sahanrashmikaslk/BJT_Amplifier-Using_Proteus/BJT_Amplifier-Report.pdf

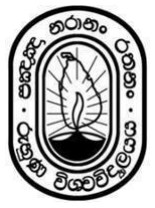
[picture p7: figure]

# BJT AMPLIFIER DESIGN

### A report submitted to the

### Department of Electrical and Information Engineering

### Faculty of Engineering

### University of Ruhuna Sri Lanka

### On 20th SEP 2023

### In completing an assignment for the module

### EE 4105 – Electronics Project

By

### Group 17

EG/2020/4036 | KUMARI H.M.M.S
EG/2020/4038 | KURUWITAARACHCHI K.A.D.T.T
EG/2020/4040 | LAKPAHANA A.G.S
EG/2020/4044 | LAKSHANI P.N.K
EG/2020/4047 | LELWALA L.G.S.R

ABSTRACT

This project report primarily revolves around the construction of a common emitter BJT amplifier that meets specific criteria for gain and bandwidth. It encompasses the entire journey of creating this amplifier, starting from the initial idea to the final product. This comprehensive process includes defining design specifications, performing critical calculations, simulating the circuit, designing the PCB layout, physically building the amplifier, analyzing the results, and drawing meaningful conclusions.

PERFACE

In the scope of our EE4105 - Electronic Project module, our team effectively tackled the challenge

of crafting a customized BJT amplifier with precise gain and bandwidth specifications. This

project provided us with invaluable insights into the intricacies of BJT amplifier design. The

following report serves as a detailed record of our discoveries and accomplishments throughout

this journey. We would like to express our sincere gratitude to Mr. Saman De Silva, our instructor

for the EE4105 module in the Department of Electrical and Electronic Engineering, for granting us

the opportunity to compile this report and for his continuous guidance and motivation.

Group 17:

EG/2020/4036 | KUMARI H.M.M.S
EG/2020/4038 | KURUWITAARACHCHI K.A.D.T.T
EG/2020/4040 | LAKPAHANA A.G.S
EG/2020/4044 | LAKSHANI P.N.K
EG/2020/4047 | LELWALA L.G.S.R

Department of Electrical and Information Engineering,

University of Ruhuna.

TABLE OF CONTENT

LIST OF FIGURES

### 1. Introduction

The common emitter amplifier, which is a voltage amplification circuit, consists of a three-terminal

bipolar junction transistor in a single-stage configuration. In this setup, it acquires its input signal

via the base terminal, collects the amplified output from the collector terminal, and links the emitter

terminal to both the input and output sides.

This single-stage common emitter amplifier circuit relies on Voltage Divider Biasing, a specific

biasing technique. Within this method, two resistors form a voltage division network across the

power supply, and the midpoint of this network generates the necessary base bias voltage for the

transistor. Voltage divider biasing is a widely adopted strategy when designing amplifier circuits

based on bipolar transistors.

### 1.1. Problem Statement

The project task was to implement a Common Emitter BJT amplifier with the following

Specifications.

- Voltage gain | = 400
- Bandwidth of Low Pass Filter | = 1.5kHz

This amplifier is designed to amplify weak audio signals, eliminate unwanted high-frequency noise, and invert the signal's phase as needed in audio applications.

### 1.2. Objectives

- By having a knowledge about how BJT is amplify by controlling the current flow we have to understand the construction and working principle of BJT amplifiers
- Component values like resistors and capacitors are calculated based on given

specifications to ensure the circuit's intended performance

- Sketch and simulate the designed common emitter amplifier circuit by proteus for insights into its behavior.
- Implementation on a PCB layout requires precision in component placement and routing,

often visualized in 3D.

- Comparing the theoretical and experimental results checks the design and helps make it

better, showing how electronics engineering often involves trying, testing, and improving

### 1.3. Methodology

- Gather information like how much it should amplify the signal, what frequencies it should work with on the BJT common emitter amplifier to compute component values.
- Select an appropriate transistors based on the calculated voltage and current values.
- Develop a block diagram that illustrates the amplifier and filter stages.
- Perform the necessary calculations to determine component values according to specified characteristics.
- Utilize Proteus software to simulate the designed circuit. This helps you to see the design works on the computer properly and if there are any issues, fix them through troubleshooting.
- Implement the circuit design on a printed circuit board
- Concluding the theoretical and practical performances of the design by mentioning the

conclusions of this report.

- Preparing and presenting the final design and the report.

### 2. Design of the Amplifier

### 2.1. Top Level Construction of the Design

In the amplifier design, it is expected the amplifier gain should be 400 and the bandwidth

should be 1.5kHz.

The 400 gain is somewhat higher gain than the normal cases. So we cannot achieve this through

only one amplifier. So here two amplifiers are used cascading. Then for the achieve bandwidth

requirement, filter is used and the buffer circuits ensure the input/output impedance matching at

various stages as the beginning, middle of two amplifiers and the end of the amplifier in the

amplifier circuit.

The block diagram of the amplifier circuit as follows.

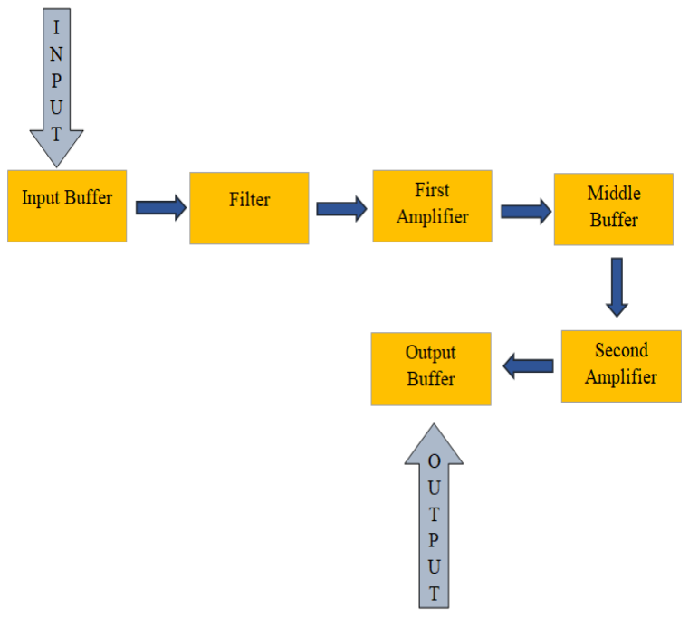
[picture p8: figure]

Figure 1 : Block Diagram of the Amplifier Circuit

### 2.1.1. Input Buffer

The BJT Common collector amplifier is used as input buffer to match the impedance of input

signal source with the amplifier. The gain is nearly about 1 and the bandwidth is much higher

than 1.5kHz.

### 2.1.2. Filter

Second order low pass Butterworth filter is used for achieve the bandwidth of 1.5kHz. The filter

gain is about 1. Then bandwidth is 1.5kHz.

### 2.1.3. First Amplifier

The BJT Common-emitter amplifier is used as first amplifier for the circuit. The gain of the first

amplifier is 20. Bandwidth is much more than 1.5kHz.

### 2.1.4. Middle Buffer

The BJT Common collector amplifier is use as middle buffer to match the output impedance of

the first filter and the input of the second filter. The gain is about 1 and bandwidth is much more

than 1.5kHz.

### 2.1.5. Second Amplifier

The BJT Common-emitter amplifier is used as second amplifier for the circuit. The gain of the

second amplifier is 20. Bandwidth is much more than 1.5kHz.

### 2.1.6. Output Buffer

The BJT Common collector amplifier is use as output buffer to match the output impedance of

the second filter and the output source. The gain is about 1 and bandwidth is much more than

1.5kHz.

### 2.2. Transistor Selection

The 2N3904 NPN transistor is used for all the stages as transistor for this amplifier circuit. This

2N3904 transistor is used for input buffer, filter, first amplifier, middle buffer, second amplifier

and output amplifier in the circuit.

Common properties for this transistor is as follow.

- Continuous Collector Current | - 200mA
- DC Current Gain(Minimum) | - 100
- Input Capacitive | - 8pF

### 2.3. Calculations

Calculations for the all the buffers, filter and the amplifiers are able to done isolating each

section form others because the effect of one section is not depend on other stages.

It is chose 12V as power supply for the amplifier circuit. All the parts in the amplifier is

powered by 12V DC power supply.

### 2.3.1. Input Buffer

As above mentioned Common Collector amplifier is used as input buffer for the circuit. The

construction of the common collector amplifier as shown in the below.

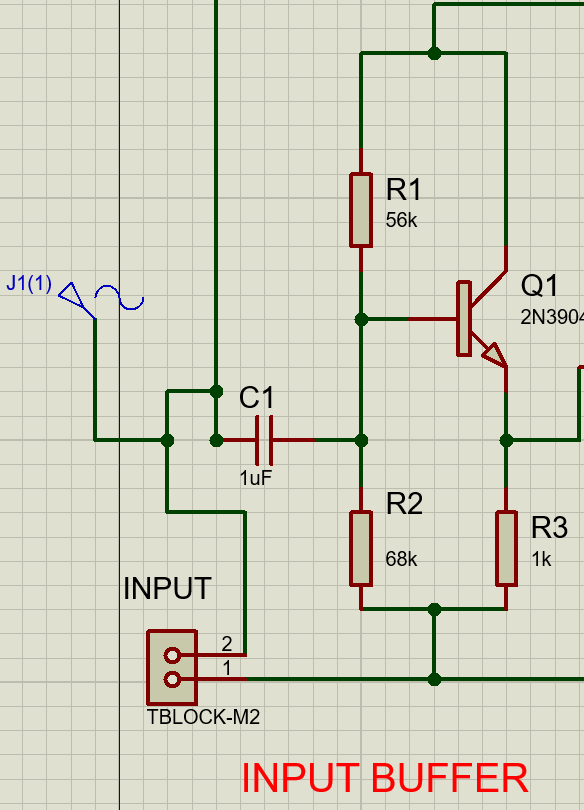
[picture p9: figure]

Figure 2 : Input Buffer Circuit

Calculations:

For a largest possible symmetric output voltage swing,

VE =

1
2

VCC

VE =

1
2

× 12V

VE = 6V

Then the Q point used for the calculations,

VCE = 6V

IC = 6mA

Normally IC ≈ IE,

Then Emitter resistor value,

RE =

VE
IE

R3 =

6V
6mA

R3 = 1kΩ

Base voltage of Q1 transistor,

VB = VE + 0.7V

VB = 6V + 0.7V

VB = 6.7V

Then R1 and R2 values are,

VB =

R2 × VCC
R1 + R2

VB = 6.7V

6.7V =

R2 × 12V
R1 + R2

R1
R2

=

5.3
6.7

R1 = 56kΩ

R2 = 68kΩ

Input impedance of the buffer

Zin = R1 ∥ R2 ∥ [βrE + (1 + β) ]RE

Hence rE ≪ RE

Zin = R1 ∥ R2 ∥ βRE

Zin = 56kΩ ∥ 68kΩ ∥ 100 × 1kΩ

Zin = 23.5kΩ

To get lower cutoff frequency around 10Hz,

C1 =

1
2π × f × Zin

C1 ≈ 1μF

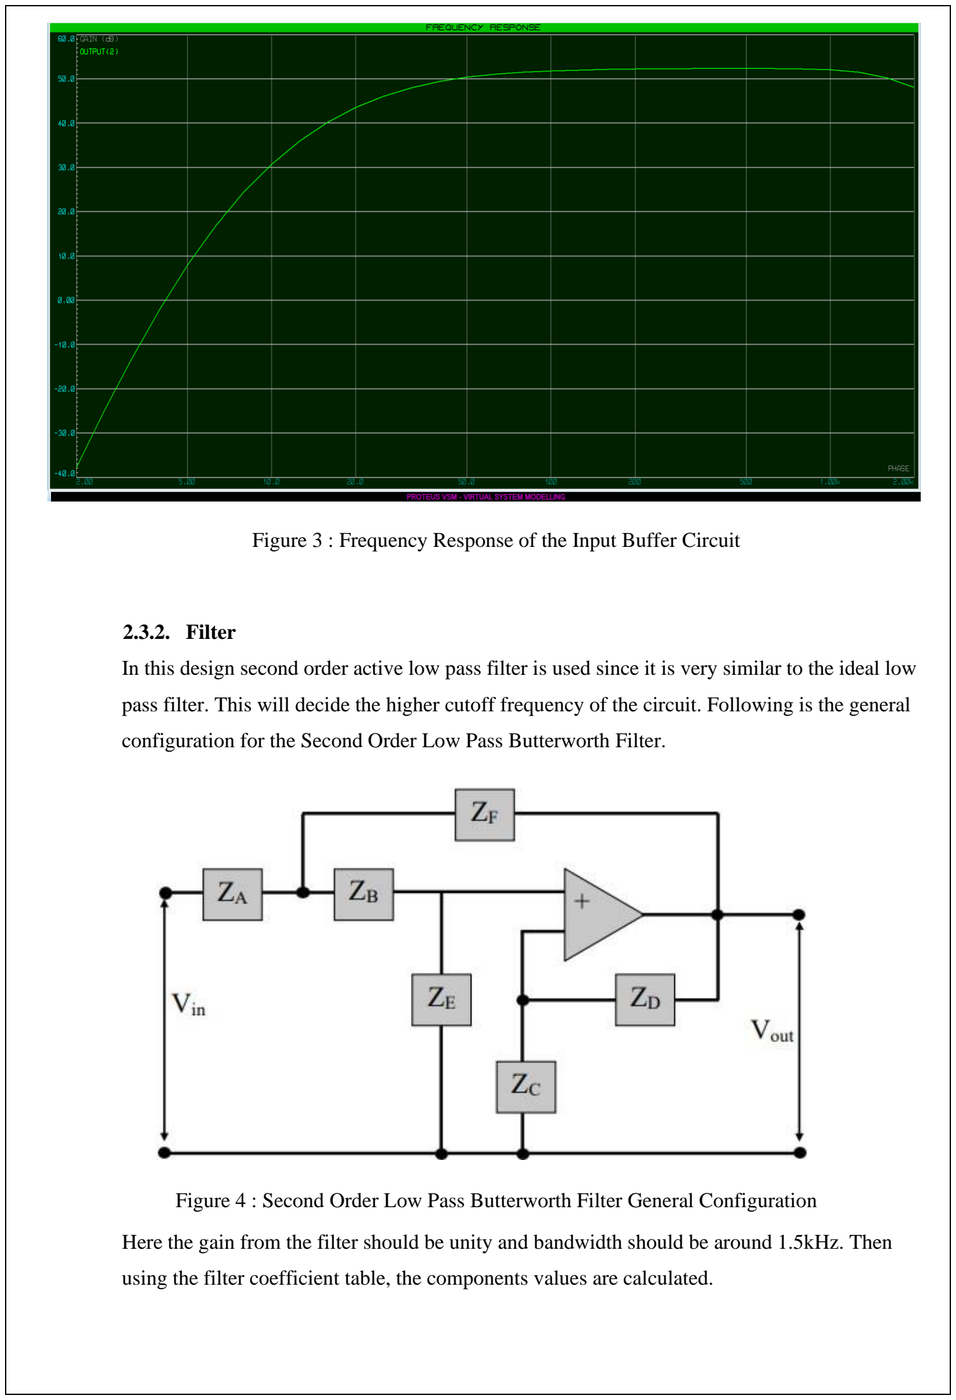
[picture p10: page 14]

Figure 3 : Frequency Response of the Input Buffer Circuit

### 2.3.2. Filter

In this design second order active low pass filter is used since it is very similar to the ideal low

pass filter. This will decide the higher cutoff frequency of the circuit. Following is the general

configuration for the Second Order Low Pass Butterworth Filter.

Figure 4 : Second Order Low Pass Butterworth Filter General Configuration

Here the gain from the filter should be unity and bandwidth should be around 1.5kHz. Then

using the filter coefficient table, the components values are calculated.

Calculations:

The value of the capacitance C is chosen as 33ηF as a standard value. Then the coefficient vale

is,

ZF = C4

C4 = 33ηF

K =

10⁻⁴
f × C

K =

10⁻⁴
1500 × 33 × 10⁻⁹

K = 2.0202

Then,

ZA = R4

R4 = 2.0202 × 1.422

R4 = 2.87kΩ

In designing the circuit R4 value is chosen as 2.7 kΩ.

ZB = R5

R5 = 2.0202 × 5.399

R5 = 10.907 kΩ

Value of R5 is 10 kΩ in the circuit.

For Unit gain Second Order Low Pass Butterworth Filter,

ZC − open

ZD = 0

ZE = C3

C3 = 0.33 × 33ηF

C3 = 10.89ηF

Since it is difficult to find 10.89ηF capacitor we have chosen it as 10ηF. Then using those

values filter can be implemented.

Then for the op amp in the filter it is used Darlington pair. Because it has high input impedance

and low output impedance which is the same characteristics of the ideal op amp.

Calculations:

For a largest possible symmetric output voltage swing,

VE =

1
2

VCC

VE =

1
2

× 12V

VE = 6V

Output impedance of the buffer,

Zout = RE ∥ rE

But rE ≪ RE

Zout = rE

rE =

26mA
IE

To get very low output impedance,

IE = 26mA

RE =

VE
IE

R8 =

6V
26mA

R8 = 220Ω

Base voltage of Q2 transistor,

VB = VE + 0.7V + 0.7V

VB = 6V + 1.4V

VB = 7.4V

Then R6 and R7 values are,

VB =

R6 × VCC
R6 + R7

VB = 7.4V

7.4V =

R6 × 12V
R6 + R7

R7
R6

=

4.6
7.4

R6 = 820kΩ

R7 = 470kΩ

Input impedance of the buffer

Zin = R7 ∥ R6 ∥ [βrE + (1 + β) ]RE

Hence rE ≪ RE

Zin = R7 ∥ R6 ∥ βRE

Zin = 470kΩ ∥ 820kΩ ∥ 100 × 220Ω

Zin = 22kΩ

To get lower cutoff frequency around 10Hz,

C1 =

1
2π × f × Zin

C1 ≈ 1μF

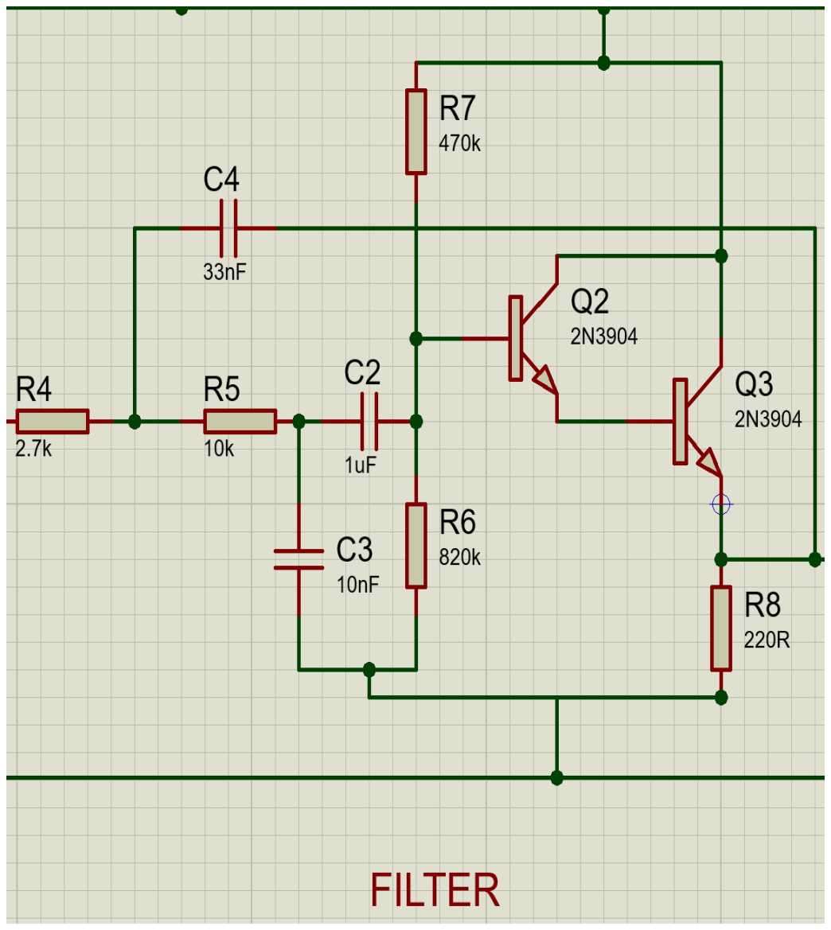
[picture p11: figure]

Figure 5 : Filter Circuit

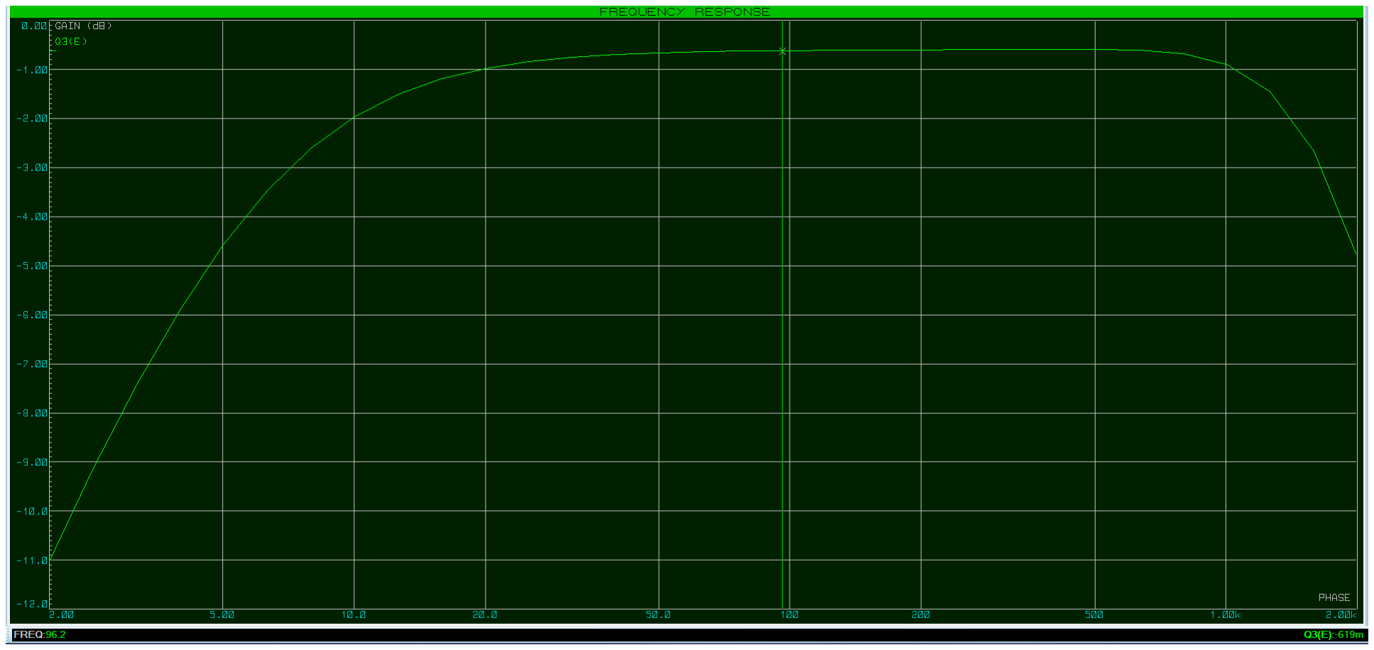
[picture p12: figure]

Figure 6 : Frequency Response of the Filter Circuit

### 2.3.3. First Amplifier

In this amplifier circuit it used two Common Emitter amplifiers to obtain high gain value of

400. Since the each stages are independent form each other stages it can calculate the

components values only for this stage independently. For the first amplifier it used 20 gain

Common Emitter amplifier.

Calculations:

AC Analysis:

VO = −iC × RC

iC = βiB

VO = −βiB × RC

iB =

Vin

rin

rin = βre

VO = −

Vin
re

× RC

Vout

Vin

= AV

AV = −

RC
re

RC = |AV

| × re

DC Analysis:

Using Kirchhoff law,

VCC = ICRC + VCE + IERE

Assuming that VCE = 5V and IC ≈ IE=2.6mA

rE =

26mV
IE

rE = 10Ω

Then using AC analysis equation,

RC = R11

R11 = 20 × 10Ω

R11 = 200Ω

R11 = 100Ω + 100Ω (Since the availability)

Using Kirchhoff law equation,

12V = (2.6mA × 220Ω) + 5V + (2.6mA × RE

)

R12 = 2.2KΩ

Base voltage,

VB = VE + VBE

VB = (IE × RE) + 0.7V

VB = 6.42 V

Then using voltage divider rule,

VB =

R10 × VCC
R9 + R10

6.42V =

R10 × 12V
R9 + R10

R9
R10

=

5.58
6.42

R9 = 1.2kΩ

R10 = 1.8kΩ

Calculate the value for C5

Zin = R9 ∥ R10 ∥ βrE

Zin = 1.2kΩ ∥ 1.8kΩ ∥ 100 × 10Ω

Zin = 420Ω

To get lower cutoff frequency around 10Hz,

C5 =

1
2π × f × Zin

C5 ≈ 33μF

Calculate the value for C7

ZE = R22 ∥ R23 ∥ rE

ZE = 1.2kΩ ∥ 1.8kΩ ∥ 10Ω

ZE = 10Ω

To get lower cutoff frequency around 10Hz,

C7 =

1
2π × f × ZE

C7 = 1591μF

C7 ≈ 1500μF

The first common emitter 20 gain amplifiers is designed as below while considering the

availability of the components,

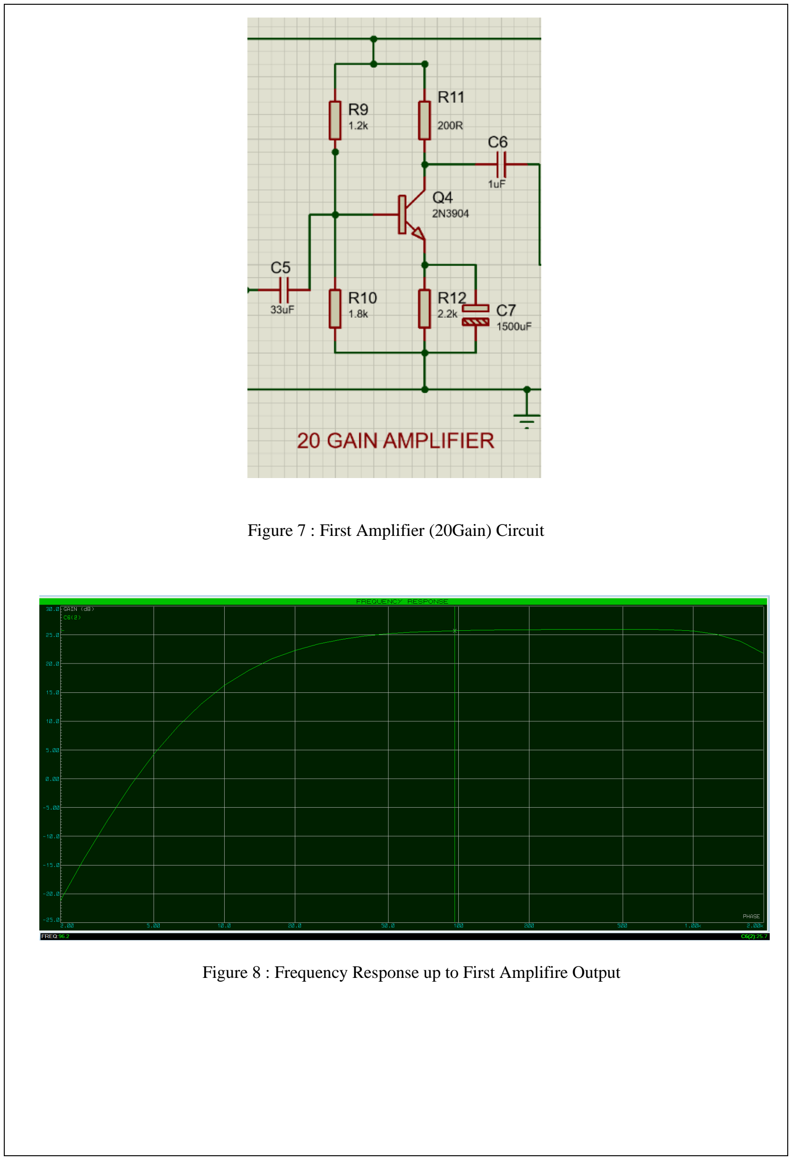
[picture p13: page 22]

Figure 7 : First Amplifier (20Gain) Circuit

Figure 8 : Frequency Response up to First Amplifire Output

### 2.3.4. Middle Buffer

As above mentioned Common Collector amplifier is used as middle buffer for the circuit. This

buffer will handle the impedance mismatch between first amplifier output and the second

amplifier input.

Calculations:

For a largest possible symmetric output voltage swing,

VE =

1
2

VCC

VE =

1
2

× 12V

VE = 6V

Then the Q point used for the calculations,

VCE = 6V

IC = 6mA

Normally IC ≈ IE,

Then Emitter resistor value,

RE =

VE
IE

R15 =

6V
6mA

R15 = 1kΩ

Base voltage of Q10 transistor,

VB = VE + 0.7V

VB = 6V + 0.7V

VB = 6.7V

Then R13 and R14 values are,

VB =

R13 × VCC
R13 + R14

VB = 6.7V

6.7V =

R14 × 12V
R13 + R14

R13
R14

=

5.3
6.7

R13 = 56kΩ

R14 = 68kΩ

Input impedance of the buffer

Zin = R13 ∥ R14 ∥ [βrE + (1 + β) ]RE

Hence rE ≪ RE

Zin = R13 ∥ R14 ∥ βRE

Zin = 56kΩ ∥ 68kΩ ∥ 100 × 1kΩ

Zin = 23.5kΩ

To get lower cutoff frequency around 10Hz,

C6 =

1
2π × f × Zin

C6 = 0.677μF

C6 ≈ 1μF

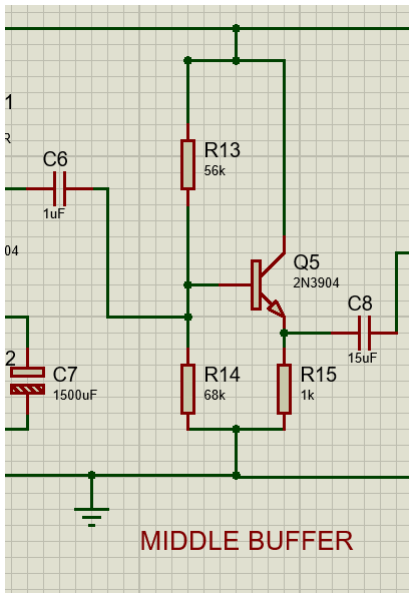
[picture p14: figure]

Figure 9 : Middle Buffer Circuit

### 2.3.5. Second Amplifier

In this amplifier circuit it used two Common Emitter amplifiers to obtain high gain value of

400. Since the each stages are independent form each other stages it can calculate the

components values only for this stage independently. For the second amplifier it also used 20

gain Common Emitter amplifier.

Calculations:

AC Analysis:

VO = −iC × RC

iC = βiB

VO = −βiB × RC

iB =

Vin

rin

rin = βre

VO = −

Vin
re

× RC

Vout

Vin

= AV

AV = −

RC
re

RC = |AV

| × re

DC Analysis:

Using Kirchhoff law,

VCC = ICRC + VCE + IERE

Assuming that VCE = 5V and IC ≈ IE=2.6mA

rE =

26mV
IE

rE = 10Ω

Then using AC analysis equation,

RC = R18

R18 = 20 × 10Ω

R18 = 200Ω

R18 ≈ 220Ω (Since availability)

Using Kirchhoff law equation,

12V = (2.6mA × 220Ω) + 5V + (2.6mA × RE

)

R19 = 2.2KΩ

Base voltage,

VB = VE + VBE

VB = (IE × RE) + 0.7V

VB = 6.42 V

Then using voltage divider rule,

VB =

R17 × VCC
R16 + R17

6.42V =

R17 × 12V
R16 + R17

R16
R17

=

5.58
6.42

R16 = 1.2kΩ

R17 = 1.8kΩ

Calculate the value for C12

Zin = R16 ∥ R17 ∥ βrE

Zin = 1.2kΩ ∥ 1.8kΩ ∥ 100 × 10Ω

Zin = 418.60Ω

Zin ≈ 420Ω

To get lower cutoff frequency around 10Hz,

C8 =

1
2π × f × Zin

C8 ≈ 15μF

Calculate the value for C16

ZE = R16 ∥ R17 ∥ rE

ZE = 1.2kΩ ∥ 1.8kΩ ∥ 10Ω

ZE = 10Ω

To get lower cutoff frequency around 10Hz,

C10 =

1
2π × f × ZE

C10 ≈ 1500μF

The second common emitter 20 gain amplifiers is designed as below while considering the

availability of the components,

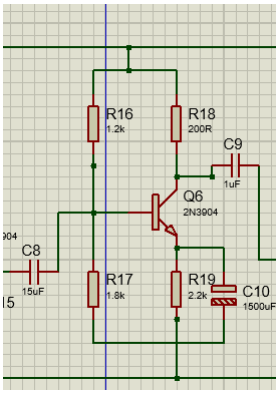
[picture p15: figure]

Figure 10 : Second Amplifier (20 Gain) Circuit

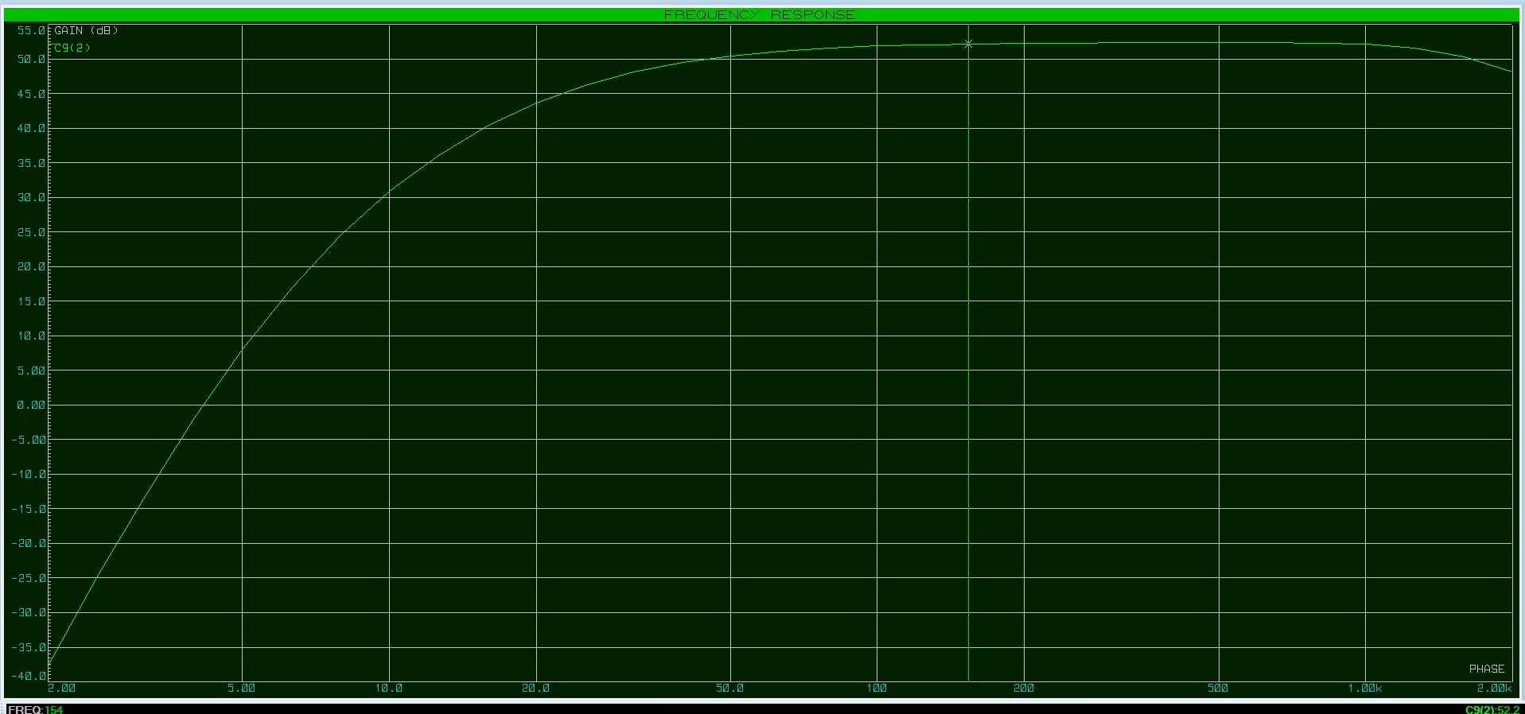
[picture p16: figure]

Figure 11 : Frequency Response up to Second Amplifier Output

### 2.3.6. Output Buffer

As above mentioned Common Collector amplifier is used as output buffer for the circuit. This

buffer will handle the impedance mismatch between second amplifier output and the output

source.

Calculations:

For a largest possible symmetric output voltage swing,

VE =

1
2

VCC

VE =

1
2

× 12V

VE = 6V

Then the Q point used for the calculations,

VCE = 6V

IC = 6mA

Normally IC ≈ IE,

Then Emitter resistor value,

RE =

VE
IE

R22 =

6V
6mA

R22 = 1kΩ

Base voltage of Q6 transistor,

VB = VE + 0.7V

VB = 6V + 0.7V

VB = 6.7V

Then R20 and R21 values are,

VB =

R21 × VCC
R20 + R21

VB = 6.7V

6.7V =

R21 × 12V
R20 + R21

R16
R17

=

5.3
6.7

R20 = 56kΩ

R21 = 68kΩ

Input impedance of the buffer

Zin = R20 ∥ R21 ∥ [βrE + (1 + β) ]RE

Hence rE ≪ RE

Zin = R20 ∥ R21 ∥ βRE

Zin = 56kΩ ∥ 68kΩ ∥ 100 × 1kΩ

Zin = 23.5kΩ

To get lower cutoff frequency around 10Hz,

C9 =

1
2π × f × Zin

C9

≈ 1μF

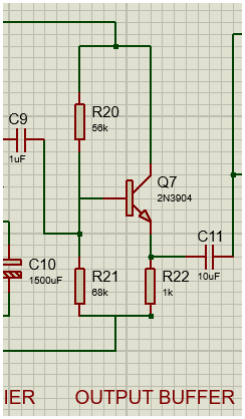
[picture p17: figure]

Figure 12 : Output Buffer Circuit

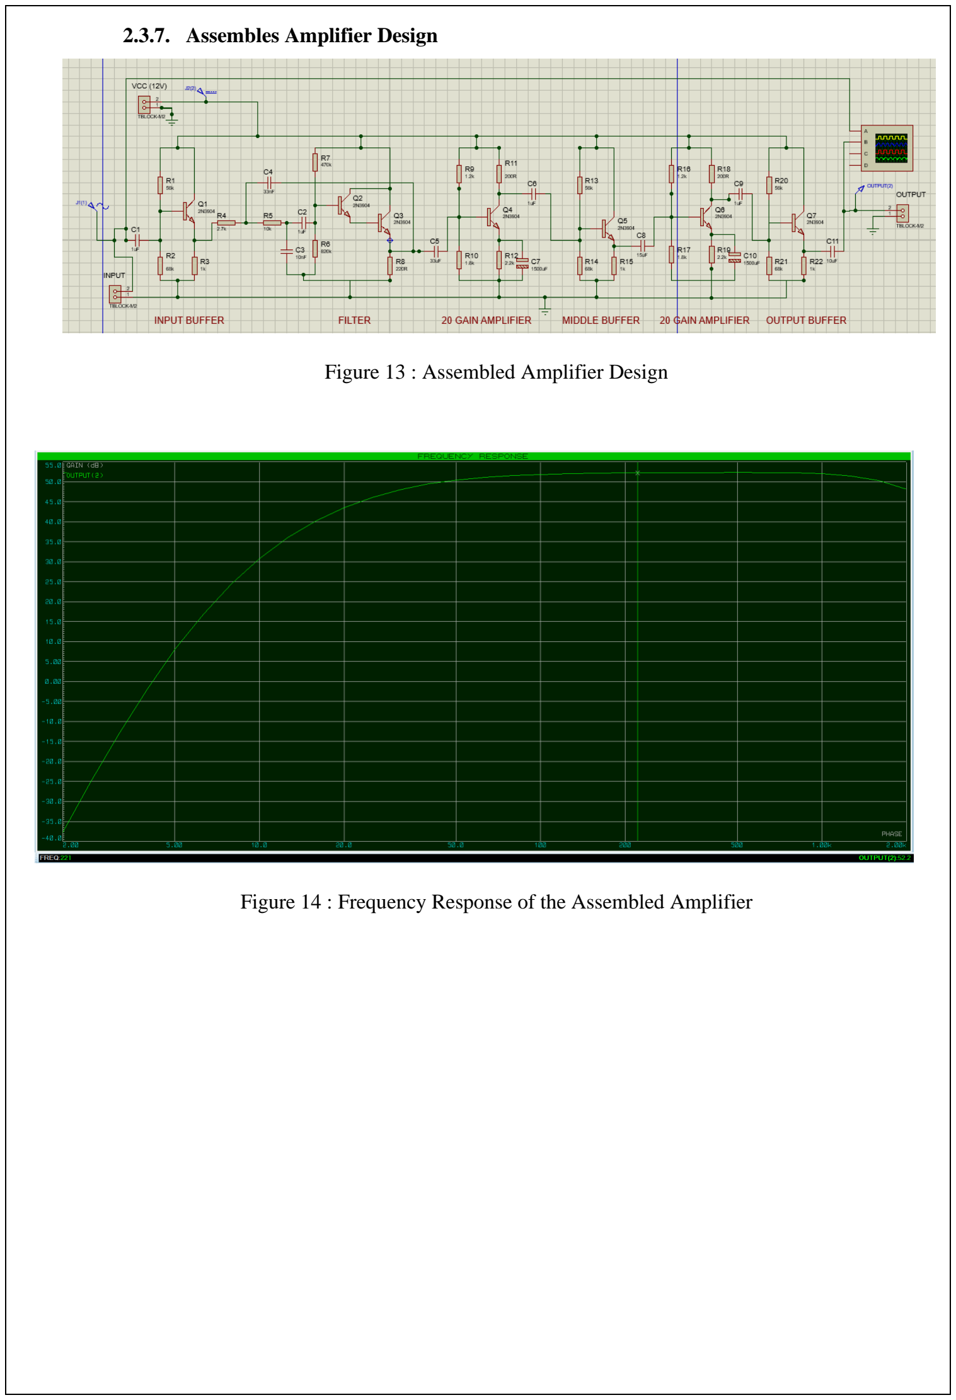
[picture p18: page 31]

### 2.3.7. Assembles Amplifier Design

Figure 13 : Assembled Amplifier Design

Figure 14 : Frequency Response of the Assembled Amplifier

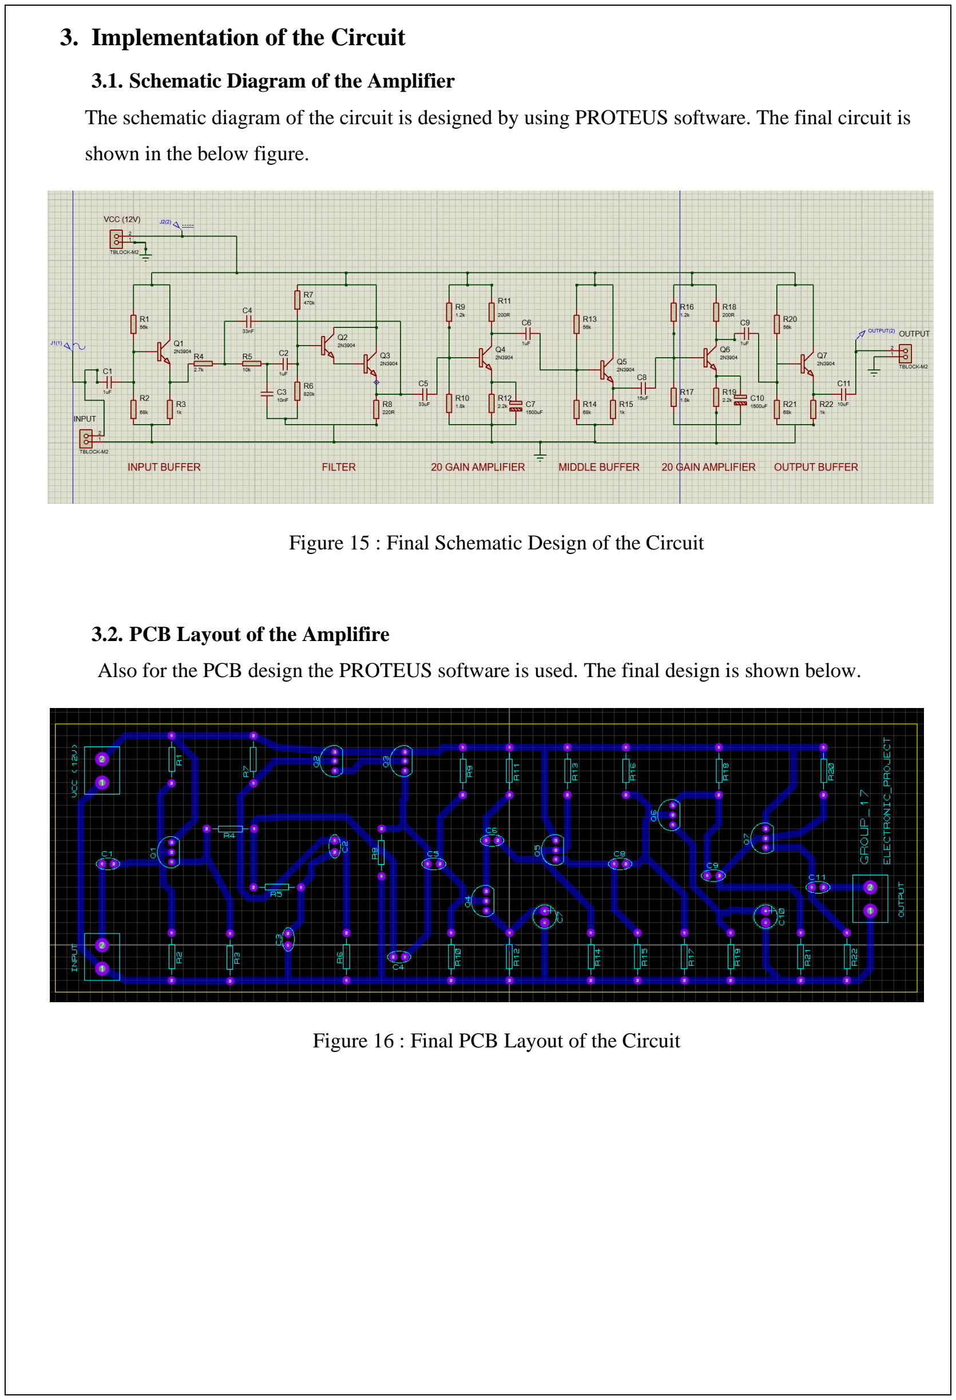
[picture p19: page 32]

### 3. Implementation of the Circuit

### 3.1. Schematic Diagram of the Amplifier

The schematic diagram of the circuit is designed by using PROTEUS software. The final circuit is

shown in the below figure.

Figure 15 : Final Schematic Design of the Circuit

### 3.2. PCB Layout of the Amplifire

Also for the PCB design the PROTEUS software is used. The final design is shown below.

Figure 16 : Final PCB Layout of the Circuit

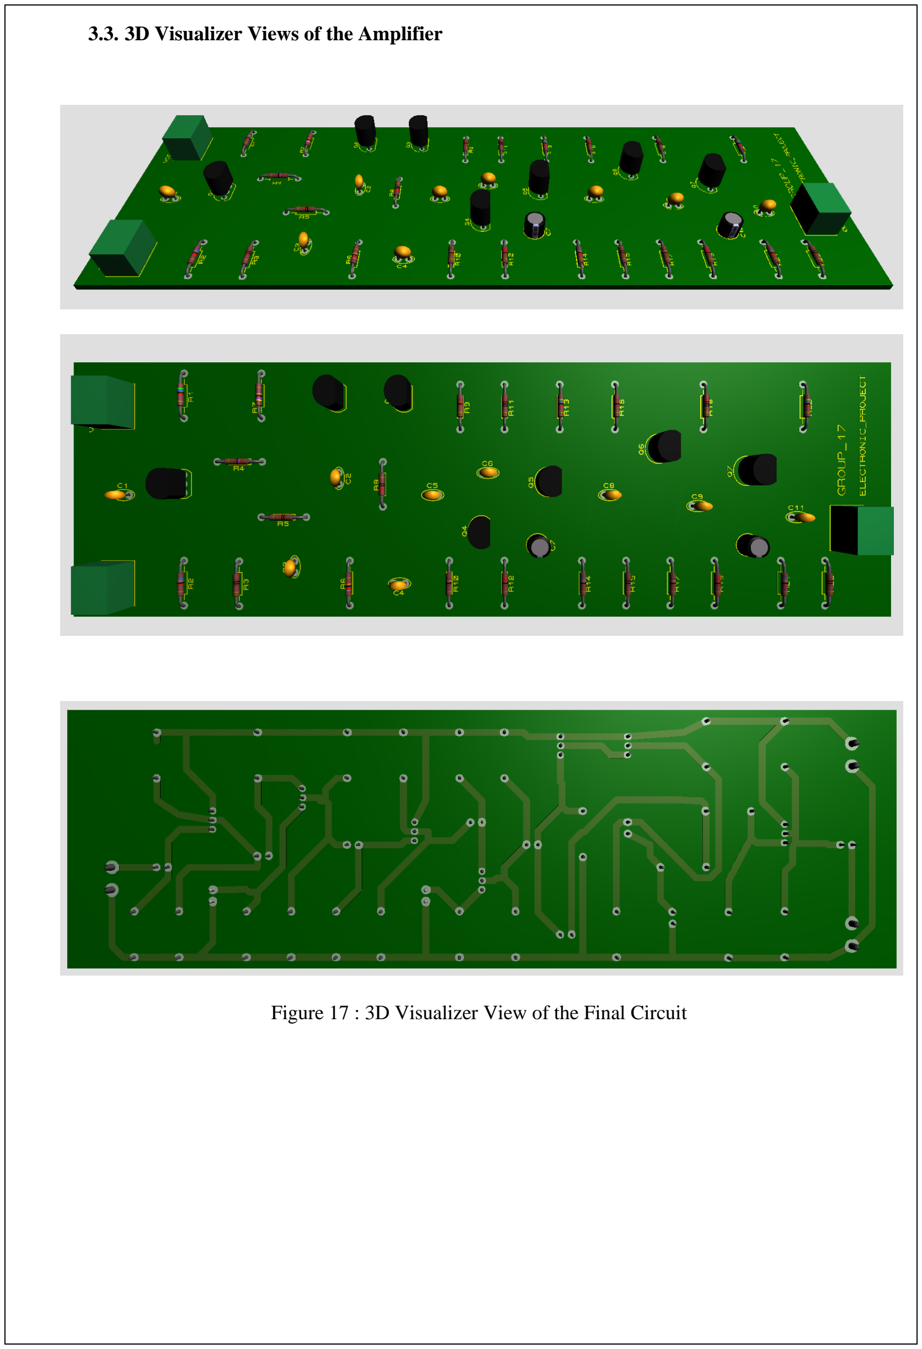
[picture p20: page 33]

3.3. 3D Visualizer Views of the Amplifier

Figure 17 : 3D Visualizer View of the Final Circuit

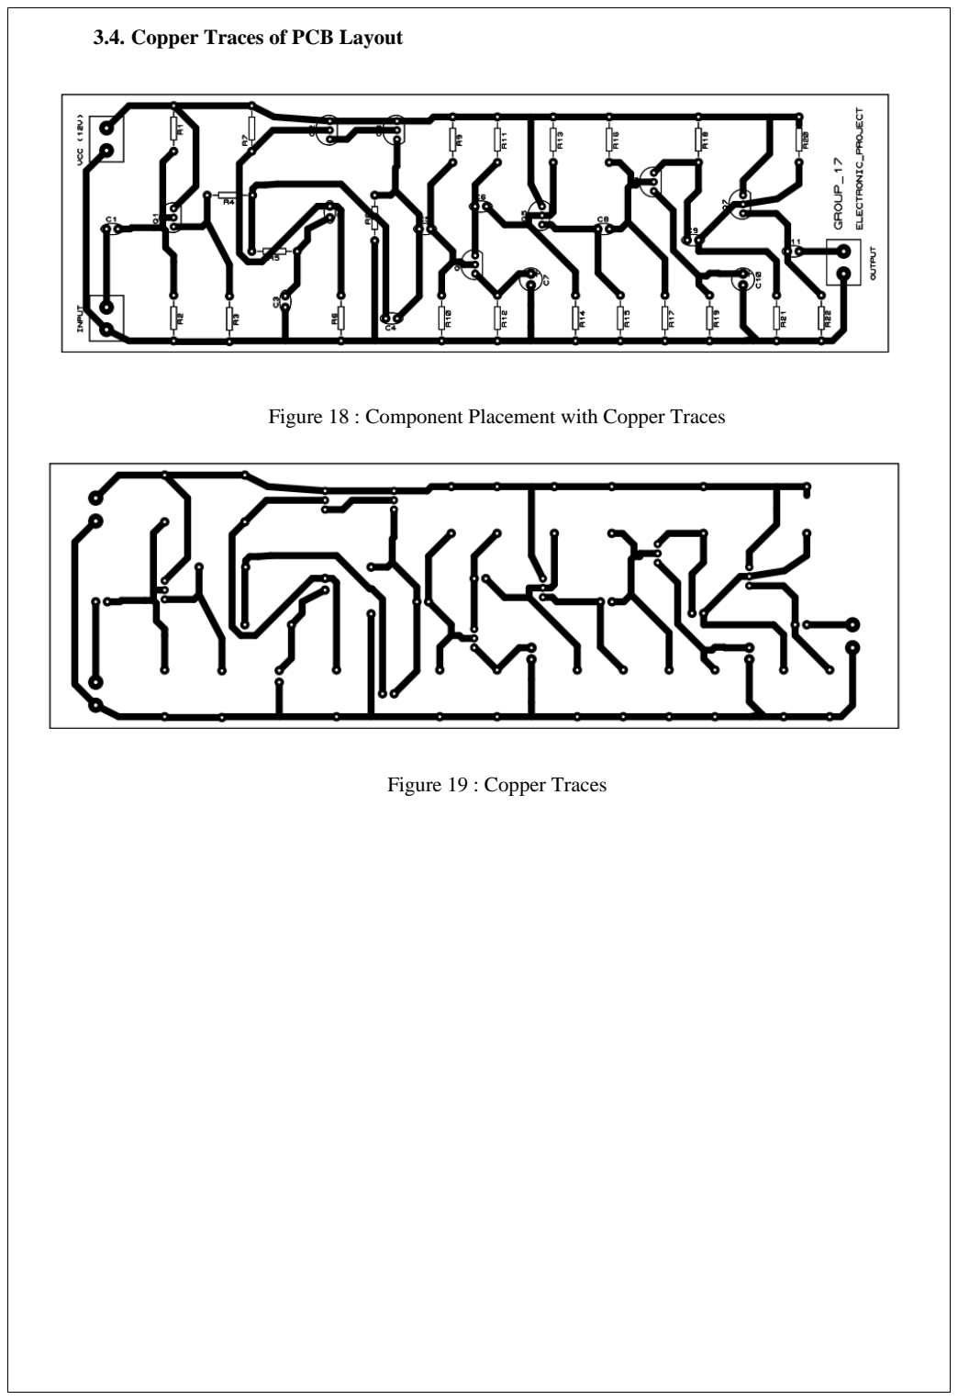
[picture p21: page 34]

### 3.4. Copper Traces of PCB Layout

Figure 18 : Component Placement with Copper Traces

Figure 19 : Copper Traces

### 3.5. Physical Implementation

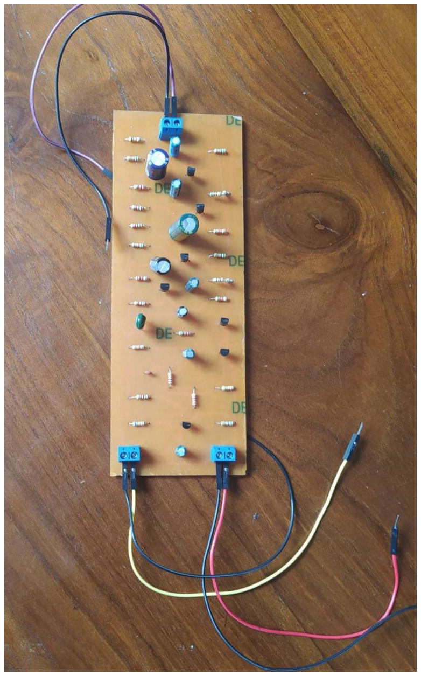
[picture p22: figure]

Figure 20: Photo of the PCB

### 4. Result and Discussion

### 4.1. Simulation Result

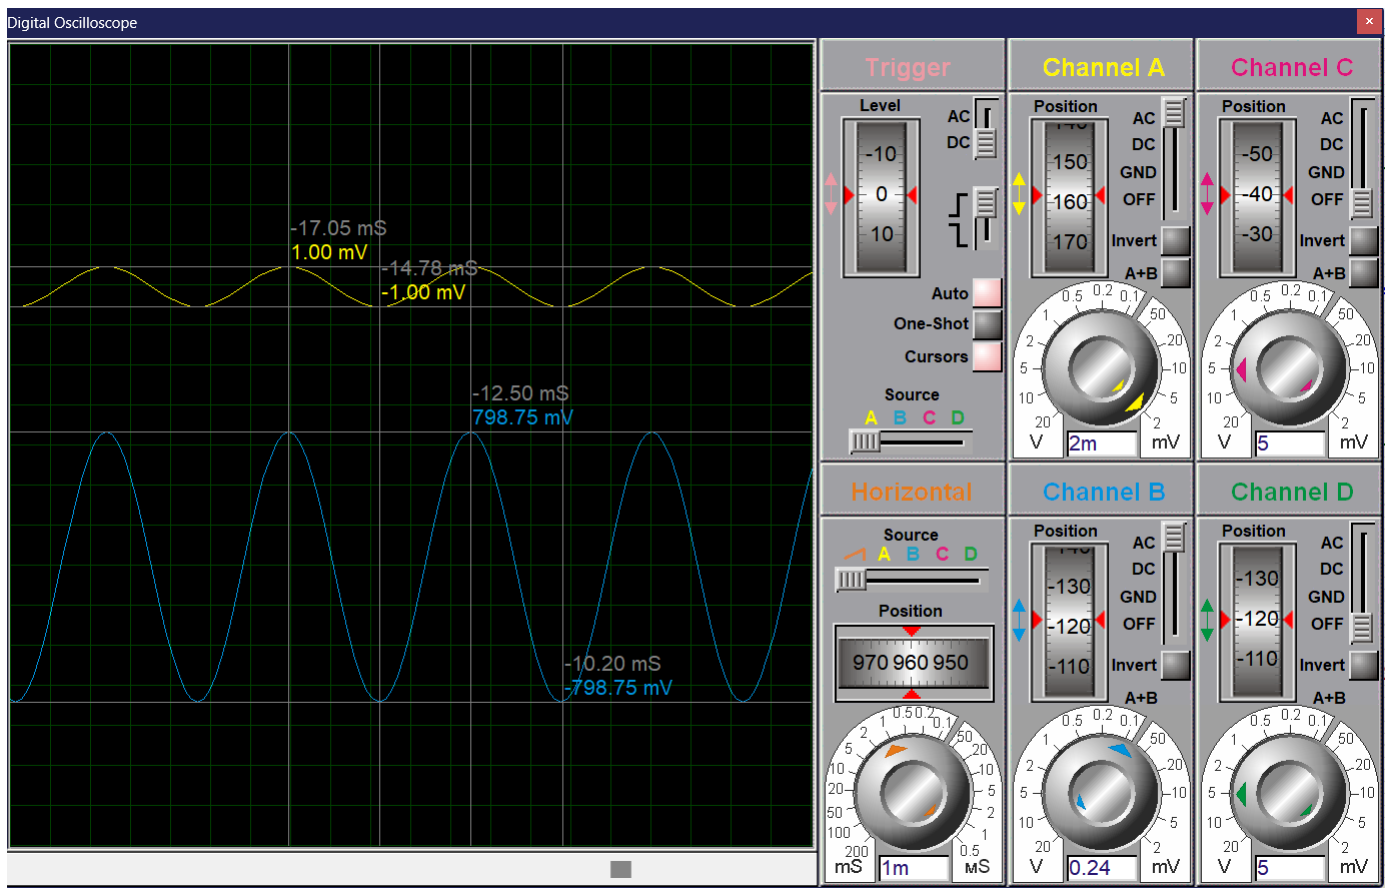
[picture p23: figure]

Figure 21 : Simulation Oscilloscope Result

Test input signal (VIN) | = 2mVPP and 220Hz
Test output signal (VOUT) | = 798mVPP and 220Hz
Gain obtain from the simulation | = AV
AV | = VOUT VIN
| = 798mV 2mV = 399

From the above amplifier circuit, we were able to obtain 400 gain roughly

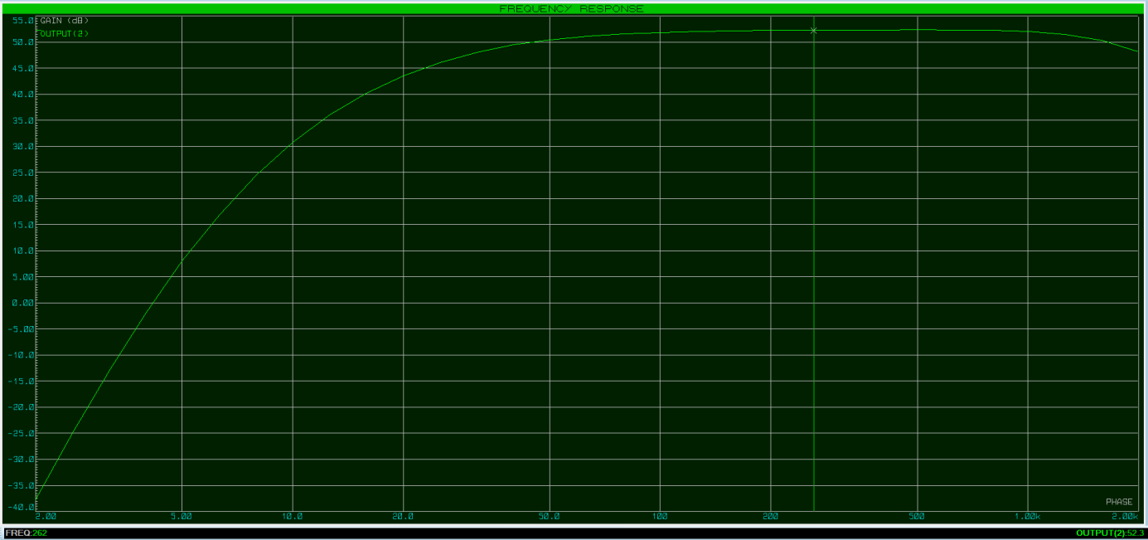
[picture p24: figure]

Figure 22 : Simulation of Frequency Response

Pass band gain | = 52.3 dB (Equivalent to 400)
Higher cutoff frequency | = 49.3 dB at 1.77kHz
Lower cutoff frequency | = 49.3 dB at 39.1 Hz
Bandwidth of the amplifier | = 1.77k – 39.1 Hz
| = 1.73 kHz

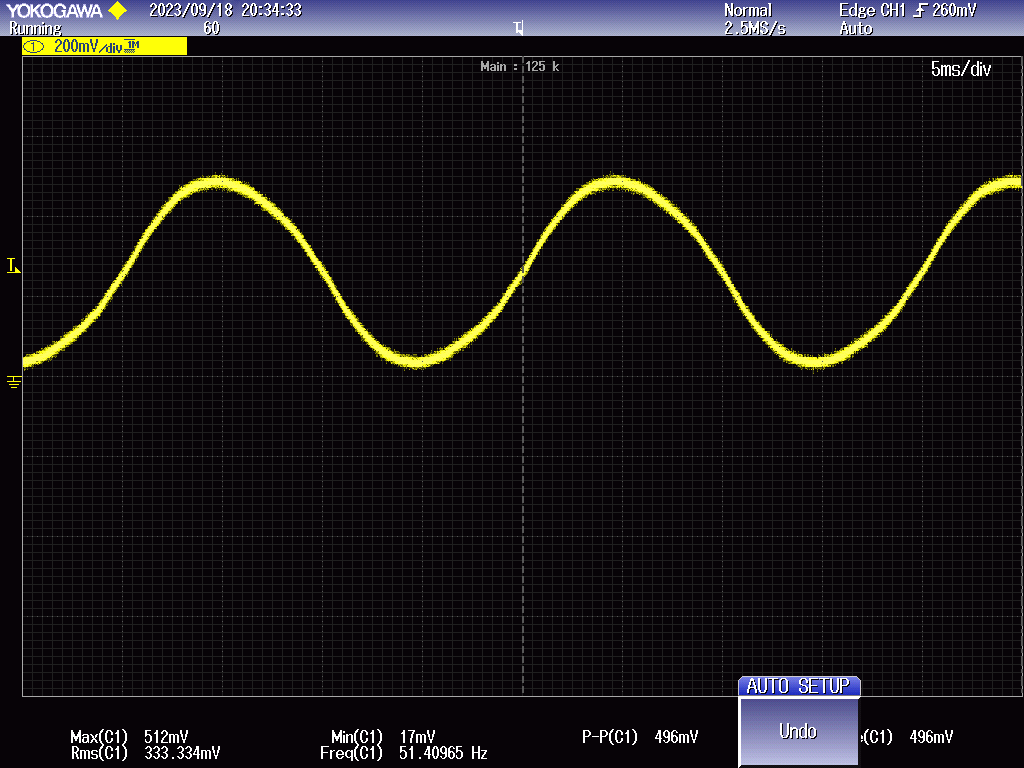
[picture p25: figure]

### 4.2. Experimental Results

### 4.3. Discussion

Certainly, here's a more detailed discussion of the factors contributing to the deviation between

theoretical and practical values in the common emitter BJT amplifier design. A common emitter BJT

amplifier was designed with specified gain of 400 and a bandwidth of 1.5kHz.

- Component Availability and Approximations:

To meet the desired gain and bandwidth specifications, we initially performed theoretical calculations

to determine component values. However, in practice, it's often challenging to find components with

exact values as calculated. We have to make this with available components that closely approximated

to our requirements. These approximations could introduce some difference.

- Impedance Mismatch:

During the experimentation phase, we used a signal generator to provide the input signal and an

oscilloscope to measure the output. However, these instruments were not accounted for the theoretical

simulations that we did using proteus. The impedance of the signal generator and the load impedance of

the oscilloscope can significantly affect the circuit's performance. The impedance mismatch could

explain some of the differences observed.

- Real-World Component Properties:

Real-world electronic components may not have ideal characteristics. Components can have noise and

tolerances that deviate from their specified values, and exhibit non-ideal behaviors, such as capacitance

and inductance. These imperfections in components can lead to variations between theoretical and

practical results of voltage gain.

- Temperature Effects:

The operating temperature of electronic components can vary in real-world conditions, impacting their

electrical properties. Resistors, for example, can exhibit resistance variations with temperature changes.

This thermal drift can cause deviations from the expected circuit behavior.

- Tolerance of Components:

The tolerance specified for resistors and capacitors can affect the observed voltage gain and bandwidth.

Components with tolerances outside the expected range can introduce variations in performance.

- Instrumental Errors:

During the experimentation, instrumental errors, such as noise in the components or the measurement

instruments, can influence the observed gain and bandwidth. These errors may not be present in

theoretical simulations but can significantly impact real-world results.

- Random Experimental Errors:

Random errors in any experimental setup can contribute to the deviation between theoretical and

practical values. These errors can include factors like measurement uncertainties and fluctuations in the

power supply voltage.
