sahanrashmikaslk/BJT_Amplifier-Using_Proteus/Bill Of Materials.pdf

## Bill Of Materials for Electronic_Project

Design Title | Electronic_Project

### Author Document Number Revision

Design Created | Saturday, September 16, 2023
Design Last Modified Saturday, September 16, 2023

### Total Parts In Design 43

0 Modules
Quantity | References | Value | Stock Code | Unit Cost
Sub-totals: | | | | $0.00
11 Capacitors
Quantity | References | Value | Stock Code | Unit Cost
4 | C1-C2,C6,C9 | 1uF
1 | C3 | 10nF
1 | C4 | 33nF
1 | C5 | 33uF
2 | C7,C10 | 1500uF
1 | C8 | 15uF
1 | C11 | 10uF
Sub-totals: | | | | $0.00
22 Resistors
Quantity | References | Value | Stock Code | Unit Cost
3 | R1,R13,R20 | 56k
3 | R2,R14,R21 | 68k
3 | R3,R15,R22 | 1k
1 | R4 | 2.7k
1 | R5 | 10k
1 | R6 | 820k
1 | R7 | 470k
1 | R8 | 220R
2 | R9,R16 | 1.2k
2 | R10,R17 | 1.8k
2 | R11,R18 | 200R
2 | R12,R19 | 2.2k
Sub-totals: | | | | $0.00
0 Integrated Circuits
Quantity | References | Value | Stock Code | Unit Cost
Sub-totals: | | | | $0.00
7 Transistors
Quantity | References | Value | Stock Code | Unit Cost
7 | Q1-Q7 | 2N3904
Sub-totals: | | | | $0.00
0 Diodes
Quantity | References | Value | Stock Code | Unit Cost
Sub-totals: | | | | $0.00
3 Miscellaneous
Quantity | References | Value | Stock Code | Unit Cost
3 | INPUT,OUTPUT,VCC(12V) | TBLOCK-M2
Sub-totals: | | | | $0.00
Totals: | | | | $0.00

Saturday, September 16, 2023 11:48:28 PM
