sahanrashmikaslk/BJT_Amplifier-Using_Proteus/(list of files, drawings)

Other design files:
Simulation.pdsprj
